starfruwuit/egr314report/docs/subfolder/index.md

---
title: This is the index to a subfolder
---

Things to discuss
