starfruwuit/egr314report/docs/00mainPage.md

---
title: Welcome
tags:
- tag1
- tag2
---
## Ella Greetis EGR314 Individual Report
[Link back to STEMteresting main page](https://egr314-2025-s-301.github.io/main-page/) <br>

Hello! My name is Ella Greetis and I'm a Robotics Engineering student. I'm in charge of the Bidirectional Internet Communication for team STEMteresting, where I'll be receiving the speed of the motor in RPM and the planet whose gravity this RPM represents, and will display that to an external user. <br>

[Link to Block Diagram: Bidirectional Internet Communication](01BlockDiagram.md) <br>
[Link to Component Selection](02componentSelection.md) <br>
[Link to Schematic](03schematic.md) <br>
[Link to Bill of Materials](04BOM.md) <br>
[Link to API](05API.md) <br>
[Link to Resources](06resources.md) <br>
