starfruwuit/egr314report/docs/06resources.md

# Resources
Download final code .zip by clicking [esp32_mqtt_final_code_05_05_2025.zip](https://github.com/user-attachments/files/20052924/esp32_mqtt_final_code_05_05_2025.zip)
