starfruwuit/egr314report/docs/todos.md

---
title: 98 Website to-do's
---
#### higher priority:
- [ ] *Component Selection assignment*
- [ ] *Schematic design assignment*

#### lower priority:
- [ ] put tabs at top of page in order
- [ ] fix [landing page](https://starfruwuit.github.io/egr314report/)
- [ ] fix links to not go back to template repo
- [ ] figure out color editing
