starfruwuit/egr314report/docs/BlockDiagram.md

---
title: 01 Block Diagram
---
Block Diagram
This block diagram for Team STEMteresting's Bidirectional Internet Communication is up-to-date as of January 31, 2025, and will continue to be updated throughout the semester.
