starfruwuit/egr314report/docs/SchematicImage05mar2025.png

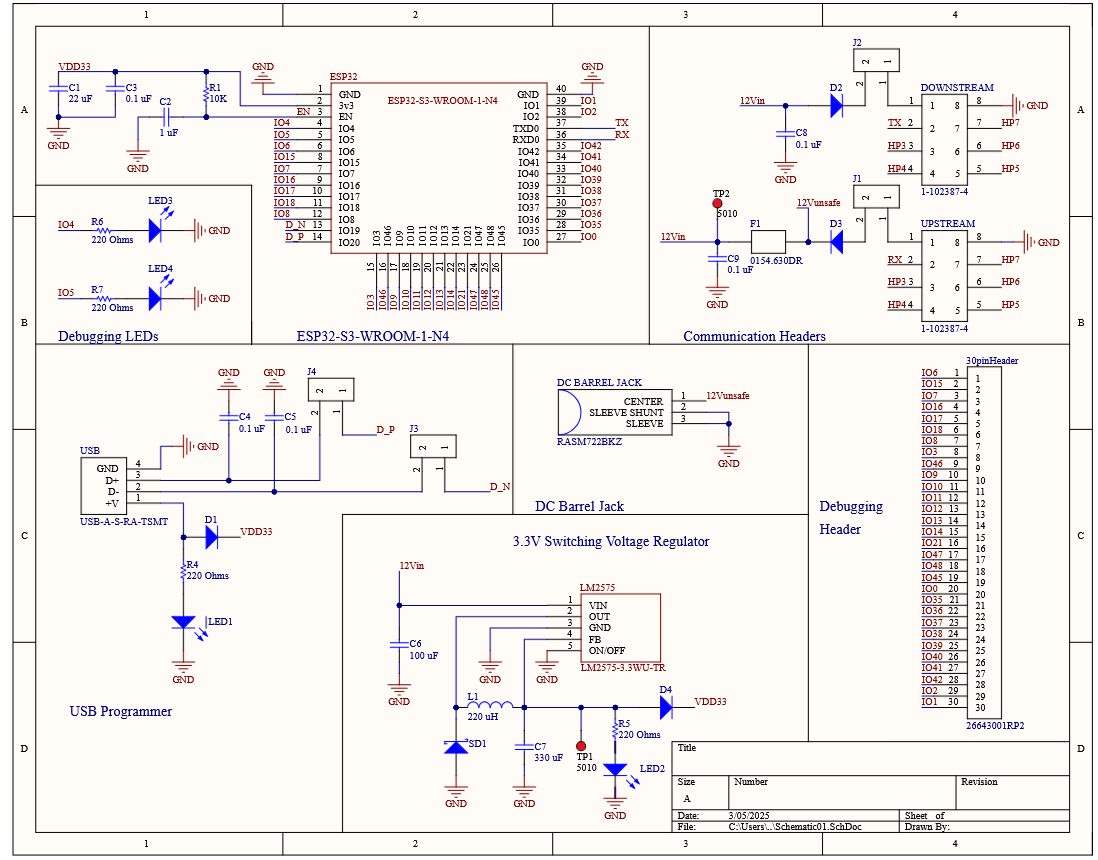
docs/SchematicImage05mar2025.png
