starfruwuit/egr314report/docs/04BOM.md

---
title: Bill of Materials
---
## For PCB: 
|Component |Part name | Quantity | Spares |Digikey link|
|---|---|---|---|---|
|ESP32 | ESP32-S3-WROOM-1-N4 |1 |2 |[digikey](https://www.digikey.com/en/products/detail/espressif-systems/ESP32-S3-WROOM-1-N4/16162639)|
|Switching Voltage Regulator |LM2575-3.3WUTR | 1 | 2 | [digikey](https://www.digikey.com/en/products/detail/microchip-technology/LM2575-3-3WU-TR/1027646) |
|Violet LEDs | APTR3216-VFX | 3 | 9 | [digikey](https://www.digikey.com/en/products/detail/kingbright/APTR3216-VFX/10293083) |
|Fuse | 0154.630DR | 1 | 2 | [digikey](https://www.digikey.com/en/products/detail/littelfuse-inc/0154-630DR/552699) |
|DC Barrel Jack | RASM722BKZ | 1 | 2 | [digikey](https://www.digikey.com/en/products/detail/switchcraft-inc/RASM722BKZ/9997459) |
|Debugging Switch | 436331045822 | 1 | 2 | [digikey](https://www.digikey.com/en/products/detail/w%C3%BCrth-elektronik/436331045822/5209092)|
|USB Programmer | USB3131-30-0230-A | 1 | 2 | [digikey](https://www.digikey.com/en/products/detail/gct/USB3131-30-0230-A/9859642) <br> Provided in class |
|Jumpers | QPC02SXGN-RC | 3 | 17 | [digikey](https://www.digikey.com/en/products/detail/sullins-connector-solutions/QPC02SXGN-RC/2618262) |
|1x2 Male Headers | n/a | 3 | 6 | n/a |
|2x15 Male Headers | n/a | 1 | 1 | n/a |
|2x4 Female Headers | 702460801 | 2 | 4 | provided in class |
|220 uH Inductor | NR10050T221M| 1 | 2 | [digikey](https://www.digikey.com/en/products/detail/taiyo-yuden/NR10050T221M/1007976) |
|0.1 uF Capacitor | KGM21NR71E104KT | 4 | 8 | [digikey](https://www.digikey.com/en/products/detail/kyocera-avx/KGM21NR71E104KT/1116281) |
|1 uF Capacitor | CL21B105KBFNNNE | 1 | 2 | [digikey](https://www.digikey.com/en/products/detail/samsung-electro-mechanics/CL21B105KBFNNNE/3886687) | 
|22 uF Capacitor | CL21A226MAYNNNE | 1 | 2 | [digikey](https://www.digikey.com/en/products/detail/samsung-electro-mechanics/CL21A226MAYNNNE/10479857) |
|100 uF Capacitor | GRM31CR61A107MEA8L | 1 | 2 | [digikey](https://www.digikey.com/en/products/detail/murata-electronics/GRM31CR61A107MEA8L/16033775) | 
|330 uF Capacitor | GRM32ER60G337ME05L | 1 | 2 | [digikey](https://www.digikey.com/en/products/detail/murata-electronics/GRM32ER60G337ME05L/6155746) |
|10K Ohm Resistor | RC1206FR-0710KL | 2 | 8 | [digikey](https://www.digikey.com/en/products/detail/yageo/RC1206FR-0710KL/728483) |
|220 Ohm Resistor | CRGCQ0805F220R| 4 | 8 | [digikey](https://www.digikey.com/en/products/detail/te-connectivity-passive-product/CRGCQ0805F220R/8576343) |
|Diodes | SD0805S020S1R0| 6 | 6 |[digikey](https://www.digikey.com/en/products/detail/kyocera-avx/SD0805S020S1R0/3749517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) |
