starfruwuit/egr314report/egr314_wifiBoard/Schematic02.pdf

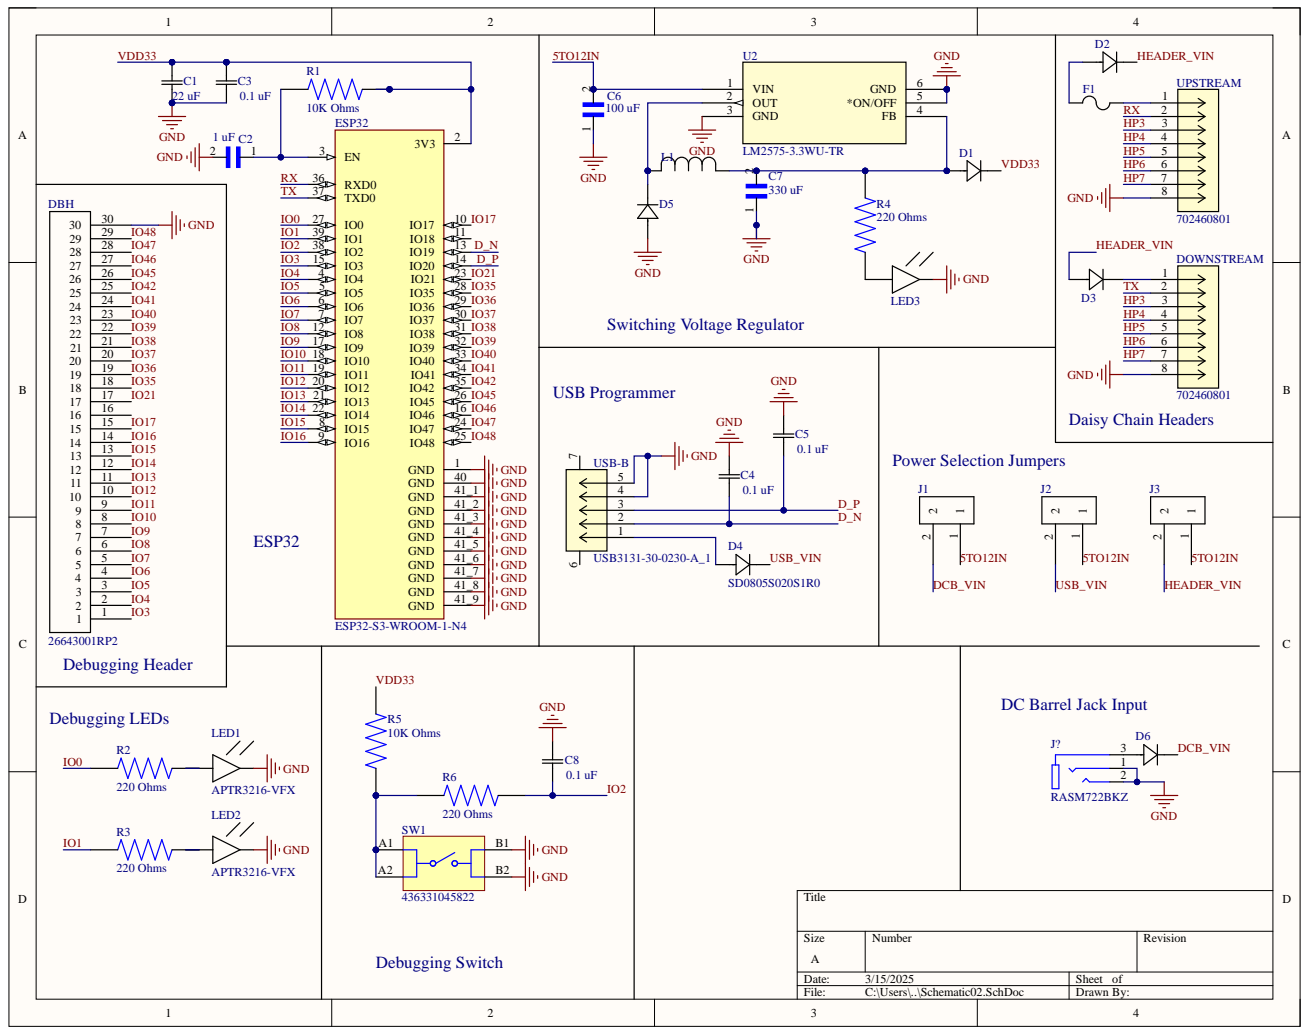
[picture p11: page 1]

DC Barrel Jack Input

Comment | Description | Designator | Footprint | LibRef | Quantity
CL21A226MAYNNNE | NoDescription Available | C1 | CAP_CL_21_SAM | CMP-017-000005-2 | 1
CL21B105KBFNNNE | 1ÂµFÂ±10%50V Ceramic Capacitor X7R0805_2012 Metric_ | C2 | CAPC2012X140N | CMP-017-000007-1 | 1
THISONE08053C104K AT2A | NoDescription Available | C3, C4, C5, C8 | CAPC2012X06N | CMP-017-000003-3 | 4
GRM31CR61A107MEA 8L | | C6 | CAPC3216X190N | CMP-017-000006-1 | 1
JMK325ABJ337MM-PE | 330ÂµFÂ±20%6.3V Ceramic Capacitor X5R1210(3225 Metric) | C7 | CAPC3225X280N | CMP-017-000008-1 | 1
SD0805S020S1R0 | NoDescription Available | D1, D2, D3, D4, D5, D6 | SD0805_AVX | CMP-024-000001-3 | 6
26643001RP2 | BoardConnector | DBH | 26643001RP2-Footprint-1 | CMP-00006-3 | 1
702460801 | NoDescription Available | DOWNSTREAM, UPSTREAM | CONN_7024608xx_MO L | CMP-004-000000-1 | 2
ESP32-S3-WROOM-1-N4 | | ESP32 | XCVR_ESP32-S3-WROOM-1-N4 | CMP-006-000000-1 | 1
0154.630DR | NoDescription Available | F1 | 0154Series_LTF | CMP-010-000000-2 | 1
2x1JUMPER | BoardConnector | J1, J2, J3 | 26640201RP2-Footprint-1 | CMP-00005-3 | 3
RASM722BKZ | | J? | SWITCHCRAFT_RASM 722BKZ | CMP-020-000000-1 | 1
NR10050T221M | NoDescription Available | L1 | INDP10198X50N | CMP-028-000000-2 | 1
APTR3216-VFX | violet LED | LED1, LED2, LED3 | SODFL350X110-2N | CMP-00009-1 | 3
10KOhms | 10kOhmsÂ±1% 0.25W, 1/4WChip Resistor 1206(3216 Metric) Moisture Resistant ThickFilm | R1, R5 | RESC3116X65N | CMP-017-000000-1 | 2
220Ohms | FixedResistor CRGCQ 0805220R1% | R2, R3, R4, R6 | RESC2012X65N | CMP-017-000002-1 | 4
436331045822 | WS-TASUSMTTact Switch withBoss Design4.7x3.5mm sidepush, SPST-NO, 12VDC, 50mA, 220g | SW1 | 436331045822 | CMP-015-000006-1 | 1
LM2575-3.3WU-TR | NoDescription Available | U2 | DPAK183P1580X460-6N | CMP-013-000001-2 | 1
USB3131-30-0230-A_1 | NoDescription Available | USB-B | USB3131-30-0230-A_1-Footprint-1 | CMP-008-000002-2 | 1
