starfruwuit/egr314report/egr314_wifiBoard/Schematic01.pdf

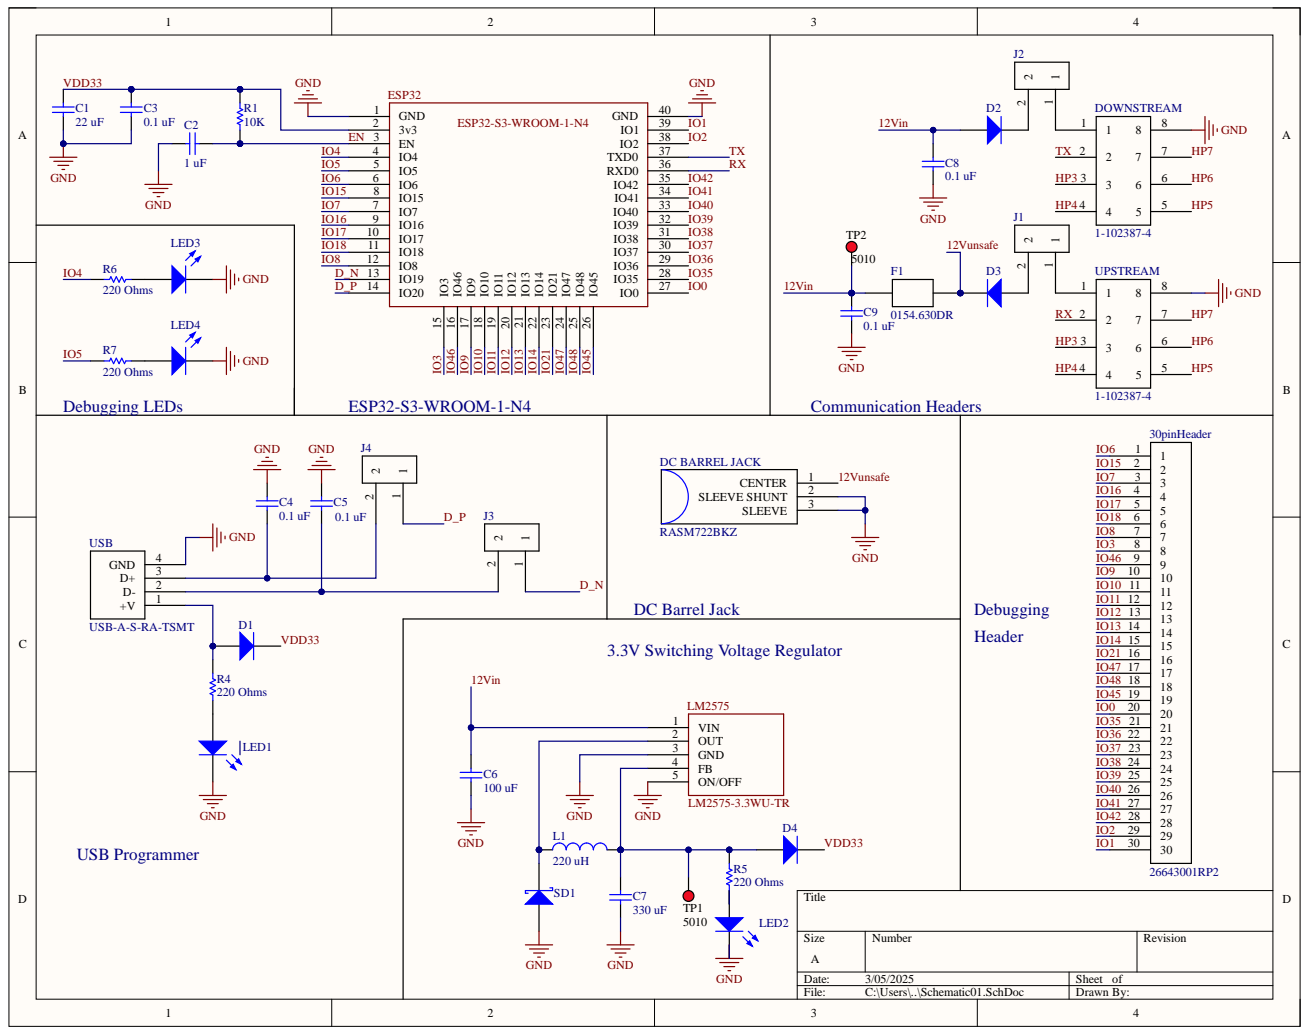
[picture p12: page 1]

Comment | Description | Designator | Footprint | LibRef | Quantity
26643001RP2 | BoardConnector | 30pinHeader | | CMP-00006-1 | 1
| Capacitor | C1 | | Capacitor | 1
Capacitor | Capacitor | C2, C3, C4, C5, C6, C7, C8, C9 | | Capacitor | 8
Diode | Diode | D1, D2, D3, D4 | | Diode | 4
RASM722BKZ | Connector, DCPower Jack, BKZLocking Series, 2.0mmSurface Mount | DCBARRELJACK | | CMP-00008-1 | 1
1-102387-4 | BoardConnector, 8 Contact(s), 2Row(s), Female, 0.1inchPitch, CrimpTerminal, Locking, Black Insulator, Receptacle | DOWNSTREAM, UPSTREAM | | CMP-00003-1 | 2
ESP32-S3-WROOM-1-N4 | WiFi-Modul 802.11/BT 2, 4-2, 5GHz150Mb/s | ESP32 | | CMP-00001-1 | 1
0154.630DR | Fuses/Accessories | F1 | | CMP-00007-1 | 1
26640201RP2 | BoardConnector | J1, J2, J3, J4 | | CMP-00005-1 | 4
Inductor | Inductor | L1 | | Inductor | 1
Light-EmittingDiode | Light-EmittingDiode | LED1, LED2, LED3, LED4 | | LED | 4
LM2575-3.3WUTR | LM2575Series3.3V1 A52KHzHigh-EfficiencyStep-Down BuckRegulator-TO-263-5 | LM2575 | | CMP-00000-1 | 1
Resistor | Resistor | R1, R4, R5, R6, R7 | | Resistor | 5
SchottkyDiode | SchottkyDiode | SD1 | | SchottkyDiode | 1
5010 | Interconnection Device | TP1, TP2 | KSTN-5010_V | CMP-00004-1 | 2
USB-A-S-RA-TSMT | ConnUSB2.0TypeAF 4POSSolder RASMD4 Terminal 1Port | USB | | CMP-00002-1 | 1
