starfruwuit/egr314report/(list of files, drawings)

Other design files:
egr314_wifiBoard/egr314_wifiBoard.PrjPcb
egr314_wifiBoard/PCB1.PcbDoc
egr314_wifiBoard/Schematic01.SchDoc
egr314_wifiBoard/Schematic02.SchDoc
