starfruwuit/egr314report/egr314_wifiBoard/Out/sizes.ini

[Page0.emf]
Pixel_PrintingWidth=5700
Pixel_PrintingHeight=4500
Mils_PrintingHeight=7500
Mils_PrintingWidth=9500
