starfruwuit/egr314report/(commit log)

2025-03-06 finished schematic
    [Schematic01.SchDoc, egr314_wifiBoard.PrjPcb]
2025-03-06 schematic download links and .zip file
    [Schematic01.SchDoc, egr314_wifiBoard.PrjPcb]
2025-03-09 working on pcb
    [Schematic01.SchDoc]
2025-03-11 more bom & docs
    [PCB1.PcbDoc, Schematic01.SchDoc, Schematic02.SchDoc, egr314_wifiBoard.PrjPcb]
2025-03-11 more BOM & schematic
    [PCB1.PcbDoc, Schematic02.SchDoc]
2025-03-11 more work
    [PCB1.PcbDoc, Schematic02.SchDoc, egr314_wifiBoard.PrjPcb]
2025-03-18 update BOM
2025-04-09 updated schematic
2025-05-06 updates
    added line breaks to schematic file and updated API file
